kbader94/OpenActionCam/documentation/git_repo_qr.png

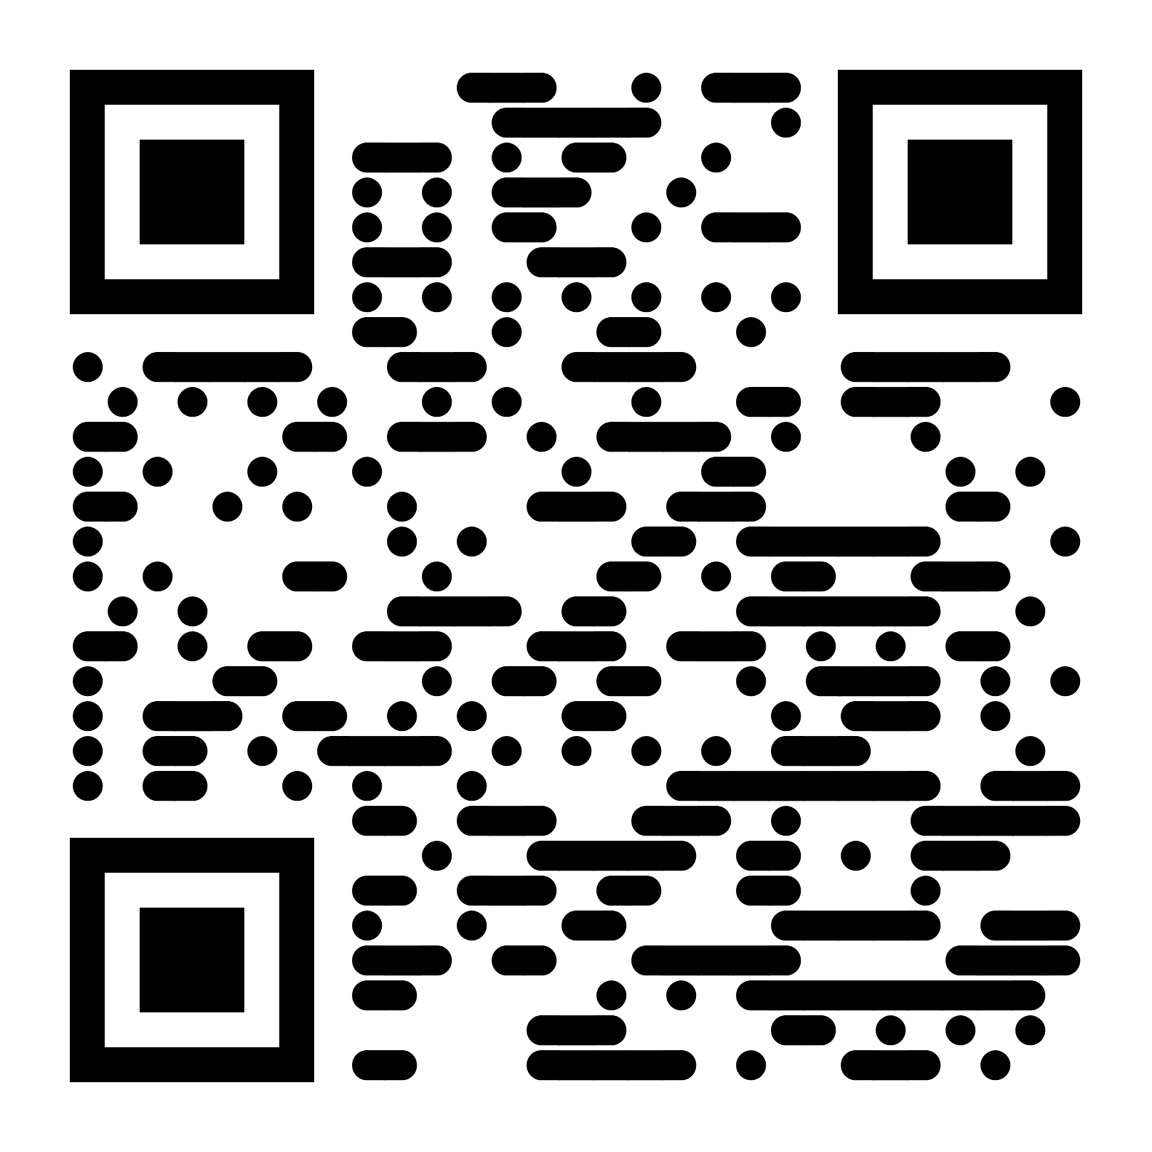
documentation/git_repo_qr.png
