kbader94/OpenActionCam/enclosure/camera_prototype_blank.FCStd

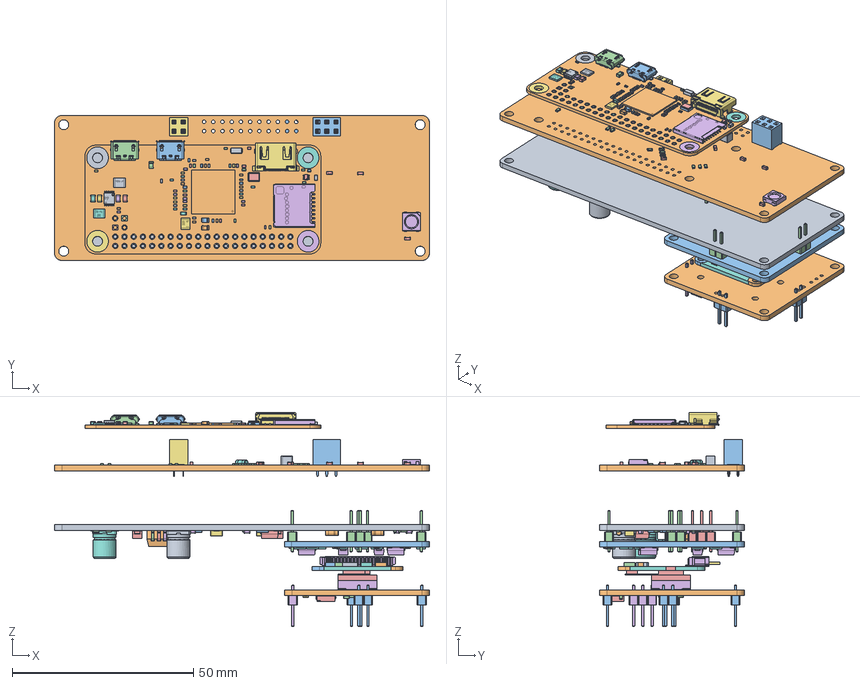
[picture p3: CAD file, 2025-04-18]
enclosure/camera_prototype_blank.FCStd
103.3 x 39.9 x 59.1 mm
Pcb_62cb
D13_D_MiniMELF_Standard_c2e3187f8d08 x 2
C33_R_1210_3225Metric_a984ca31e848 x 4
R29_R_0603_1608Metric_96e7c12605c0 x 8
D16_D_SMA_504832eae792 x 3
C21_C_0603_1608Metric_6fc8a7ce5464 x 8
F2_Fuse_1210_3225Metric_1070eb7e90c8 x 2
C_Elec_63x77
C_Elec_63x078
a648ce37-9c39-11ed-93f0-dde97e994e83_part
a648ce38-9c39-11ed-93f0-dde97e994e83_part
a648ce39-9c39-11ed-93f0-dde97e994e83_part
a648ce39-9c39-11ed-93f0-dde97e994e83_part001
a648ce39-9c39-11ed-93f0-dde97e994e83_part002
a648ce39-9c39-11ed-93f0-dde97e994e83_part003
a648ce39-9c39-11ed-93f0-dde97e994e83_part004
C8_CP_Elec_63x77_e0391a26d7e0
Pcb_15b3
J3_PinSocket_2x03_P254mm_Vertical_5ad157b1af12
R17_R_0603_1608Metric_1dbf1ae17e91 x 14
C16_C_0603_1608Metric_3bd57f6aa84f x 7
D10_LED_WS2812B_PLCC4_50x50mm_P32mm_2dee1f3dcbaa
J7_PinSocket_2x02_P254mm_Vertical_e2a5c2e6a80f
D11_D_MiniMELF_Standard_5cd850237788
C7_C_1210_3225Metric_9d8613c78238
Raspberry_pizero_PCB
Raspberry_pizero_PCB001
Raspberry_pizero_PCB002
Raspberry_pizero_PCB003
Raspberry_pizero_PCB004
Raspberry_pizero_PCB005
Raspberry_pizero_PCB006
Raspberry_pizero_PCB007
Raspberry_pizero_PCB008
Raspberry_pizero_PCB009
Raspberry_pizero_PCB010
Raspberry_pizero_PCB011
Raspberry_pizero_PCB012
Raspberry_pizero_PCB013
Raspberry_pizero_PCB014
Raspberry_pizero_PCB015
Raspberry_pizero_PCB016
Raspberry_pizero_PCB017
Raspberry_pizero_PCB018
Raspberry_pizero_PCB019
Raspberry_pizero_PCB020
Raspberry_pizero_PCB021
Raspberry_pizero_PCB022
Raspberry_pizero_PCB023
Raspberry_pizero_PCB024
Raspberry_pizero_PCB025
Raspberry_pizero_PCB026
Raspberry_pizero_PCB027
Raspberry_pizero_PCB028
Raspberry_pizero_PCB029
Raspberry_pizero_PCB030
Raspberry_pizero_PCB031
Raspberry_pizero_PCB032
Raspberry_pizero_PCB033
Raspberry_pizero_PCB034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
