kbader94/OpenActionCam/hardware/Assets/Crystal/ECS-160-20-33-TR/ECS-160-20-33-TR.step

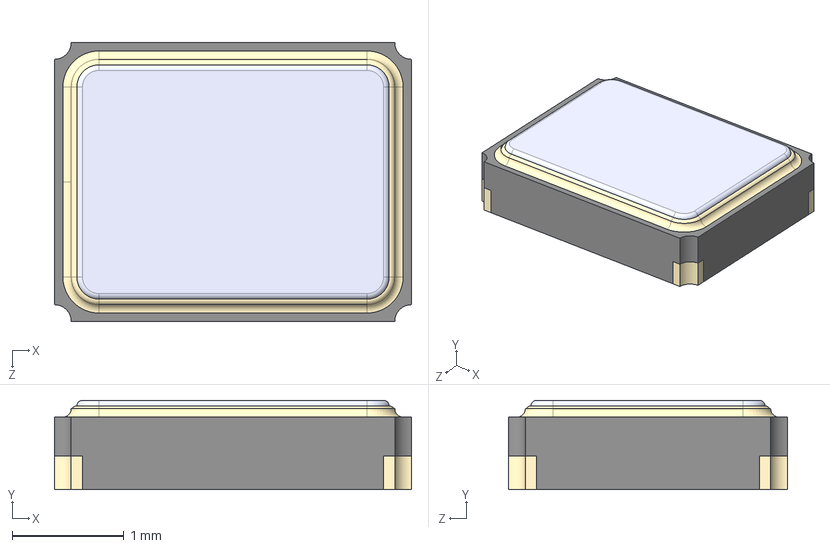
[picture p4: CAD file, 2025-05-10]
hardware/Assets/Crystal/ECS-160-20-33-TR/ECS-160-20-33-TR.step
3.20 x 0.8 x 2.50 mm
