kbader94/OpenActionCam/enclosure/Assets/Camera Moudule 3 v8.step

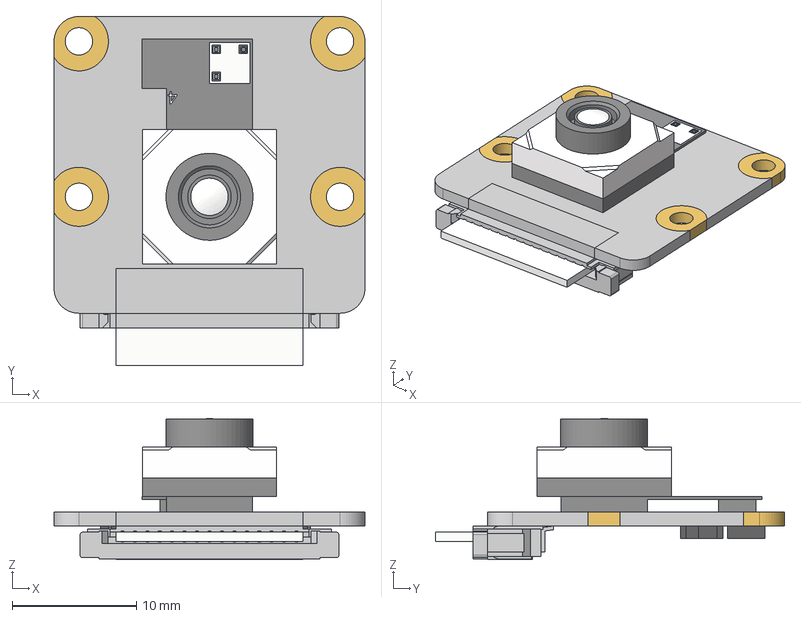
[picture p5: CAD file, 2025-04-18]
enclosure/Assets/Camera Moudule 3 v8.step
25.0 x 28.1 x 11.3 mm
Board
sfw15r3ste1lf
Sensor
Lens
Ring
Mount
Housing
