kbader94/OpenActionCam/enclosure/camera_prototype_1.FCStd

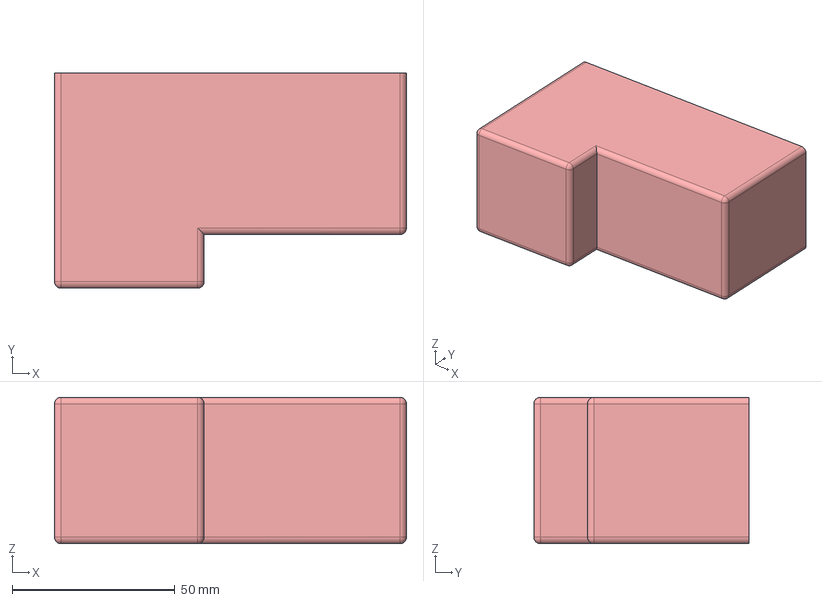
[picture p7: CAD file, 2025-04-18]
enclosure/camera_prototype_1.FCStd
108.2 x 66.2 x 45.0 mm
Pcb_580f
C12_C_0603_1608Metric_b34f059e5ce2
D9_LED_WS2812B_PLCC4_50x50mm_P32mm_70d8c241699f
R12_R_0603_1608Metric_c4ddf8fdb897
