kbader94/OpenActionCam/(list of files, cad)

Other CAD files:
enclosure/LED_Driver1.FCStd
enclosure/camera_prototype.FCStd
