kbader94/OpenActionCam/hardware/BMS/Fab/BMS-F_Fab.pdf

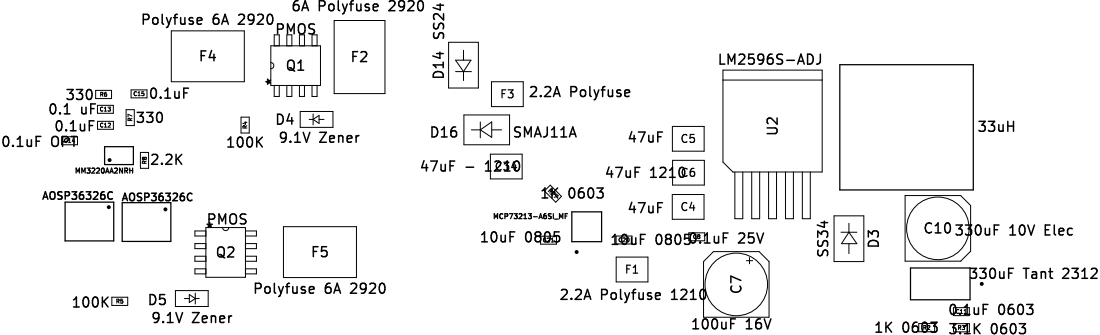
[picture p8: page 1]
