kbader94/OpenActionCam/hardware/Controller/Controller.kicad_pcb

## KiCad design hardware/Controller/Controller.kicad_pcb (2025-05-10)

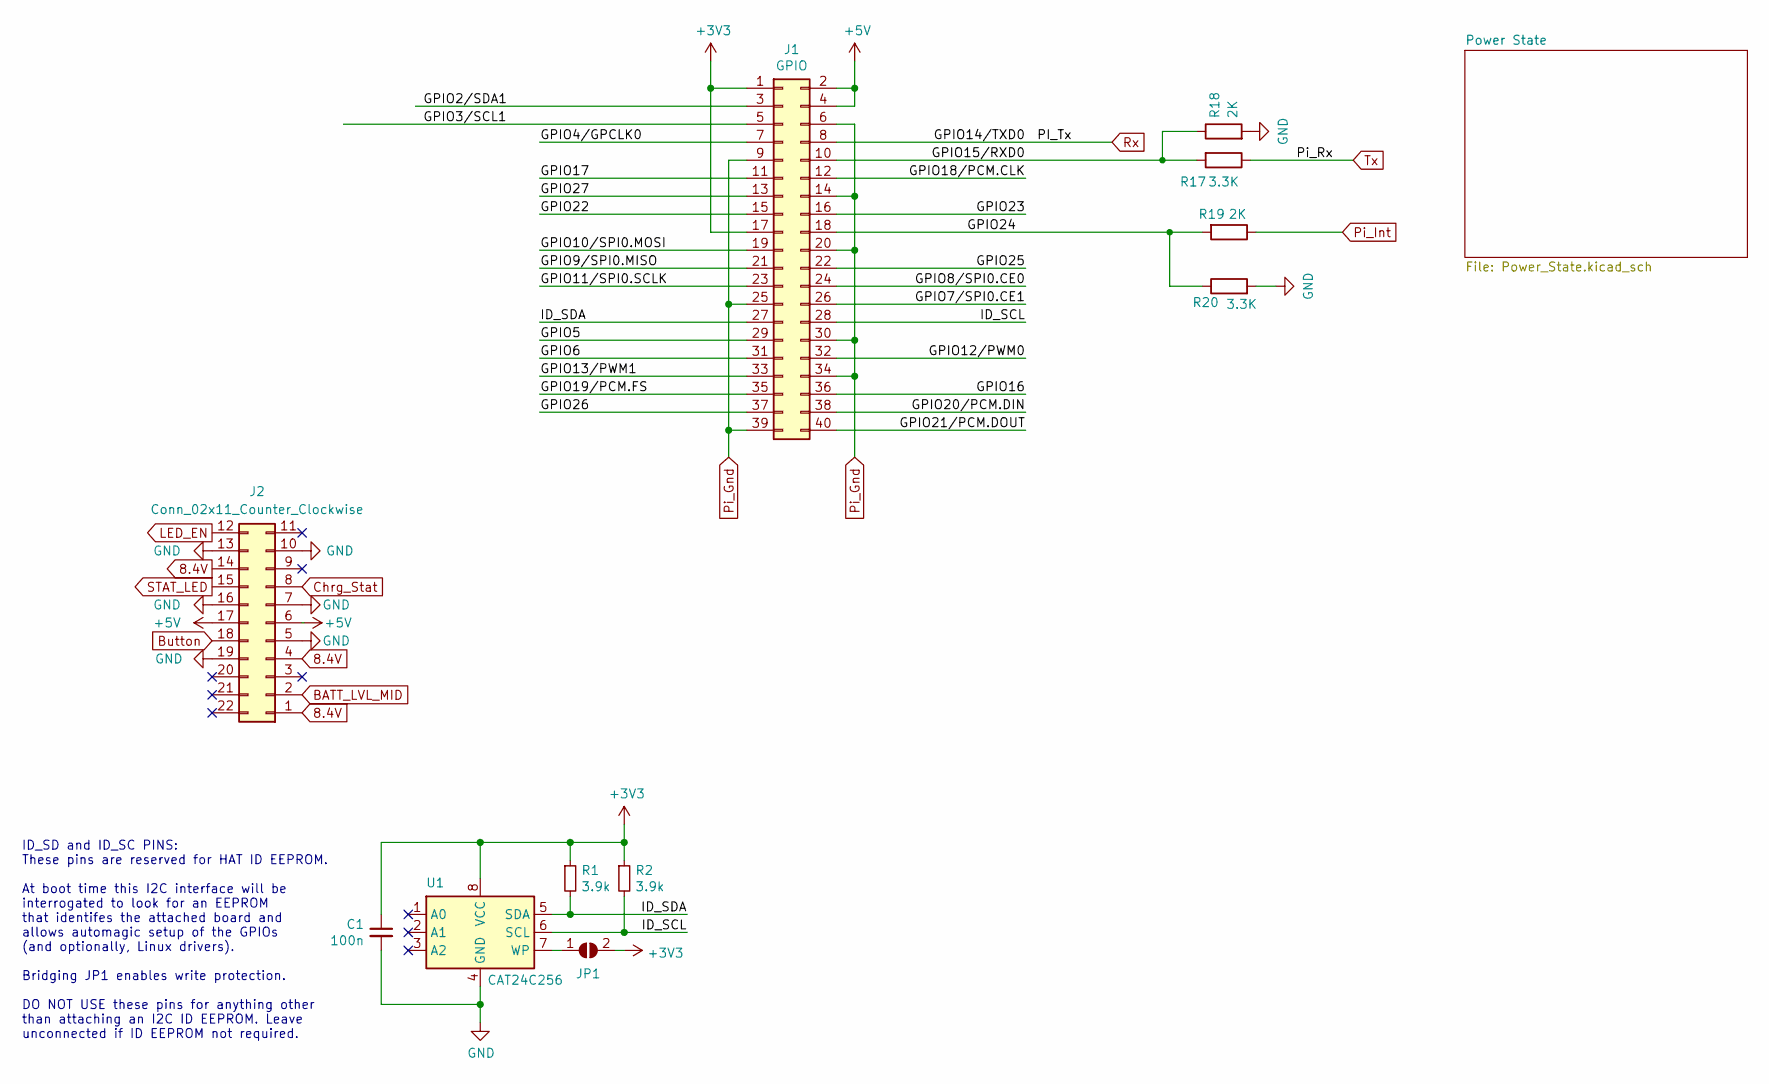
[picture p9: schematic Controller.kicad_sch, OpenActionCam]

Parts:
C1: 100n; C_0603_1608Metric_Pad1.08x0.95mm_HandSolder
J1: GPIO; Raspberry_Pi_Zero_Socketed_THT_FaceDown_MountingHoles
J2: Conn_02x11_Counter_Clockwise; Board_outline
JP1: ID_WP; SolderJumper-2_P1.3mm_Open_Pad1.0x1.5mm
R1, R2: 3.9k; R_0603_1608Metric_Pad0.98x0.95mm_HandSolder
R17, R20: 3.3K; R_0603_1608Metric_Pad0.98x0.95mm_HandSolder
R18, R19: 2K; R_0603_1608Metric_Pad0.98x0.95mm_HandSolder
U1: CAT24C256; SOIC127P600X175-8N

Connections:
8.4V: J2.1, J2.4, J2.14; also elsewhere on the board
+3V3: C1.1, J1.1, J1.17, JP1.2 (B), R1.1, R2.1, U1.8 (VCC)
+5V: J1.2, J1.4, J2.6, J2.17; also elsewhere on the board
/GPIO2/SDA1: J1.3
/GPIO3/SCL1: J1.5
/GPIO4/GPCLK0: J1.7
/GPIO5: J1.29
/GPIO6: J1.31
/GPIO7/SPI0.CE1: J1.26
/GPIO8/SPI0.CE0: J1.24
/GPIO9/SPI0.MISO: J1.21
/GPIO10/SPI0.MOSI: J1.19
/GPIO11/SPI0.SCLK: J1.23
/GPIO12/PWM0: J1.32
/GPIO13/PWM1: J1.33
/GPIO15/RXD0: J1.10, R17.2, R18.1
/GPIO16: J1.36
/GPIO17: J1.11
/GPIO18/PCM.CLK: J1.12
/GPIO19/PCM.FS: J1.35
/GPIO20/PCM.DIN: J1.38
/GPIO21/PCM.DOUT: J1.40
/GPIO22: J1.15
/GPIO23: J1.16
/GPIO24: J1.18, R19.1, R20.2
/GPIO25: J1.22
/GPIO26: J1.37
/GPIO27: J1.13
/ID_SCL: J1.28, R2.2, U1.6 (SCL)
/ID_SDA: J1.27, R1.2, U1.5 (SDA)
BATT_LVL_MID: J2.2; also elsewhere on the board
Button: J2.18; also elsewhere on the board
Chrg_Stat: J2.8; also elsewhere on the board
GND: C1.2, J2.5, J2.7, J2.10, J2.13, J2.16, J2.19, R18.2, R19.2, U1.4 (GND); also elsewhere on the board
LED_EN: J2.12; also elsewhere on the board
unnamed: JP1.1 (A), U1.7 (WP)
Pi_Gnd: J1.6, J1.9, J1.14, J1.20, J1.25, J1.30, J1.34, J1.39; also elsewhere on the board
Pi_Int: R20.1; also elsewhere on the board
Rx: J1.8; also elsewhere on the board
STAT_LED: J2.15; also elsewhere on the board
Tx: R17.1; also elsewhere on the board

Notes on the sheet:
ID_SD and ID_SC PINS: These pins are reserved for HAT ID EEPROM. At boot time this I2C interface will be interrogated to look for an EEPROM that identifes the attached board and allows automagic setup of the GPIOs (and optionally, Linux drivers). Bridging JP1 enables write protection. DO NOT USE th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

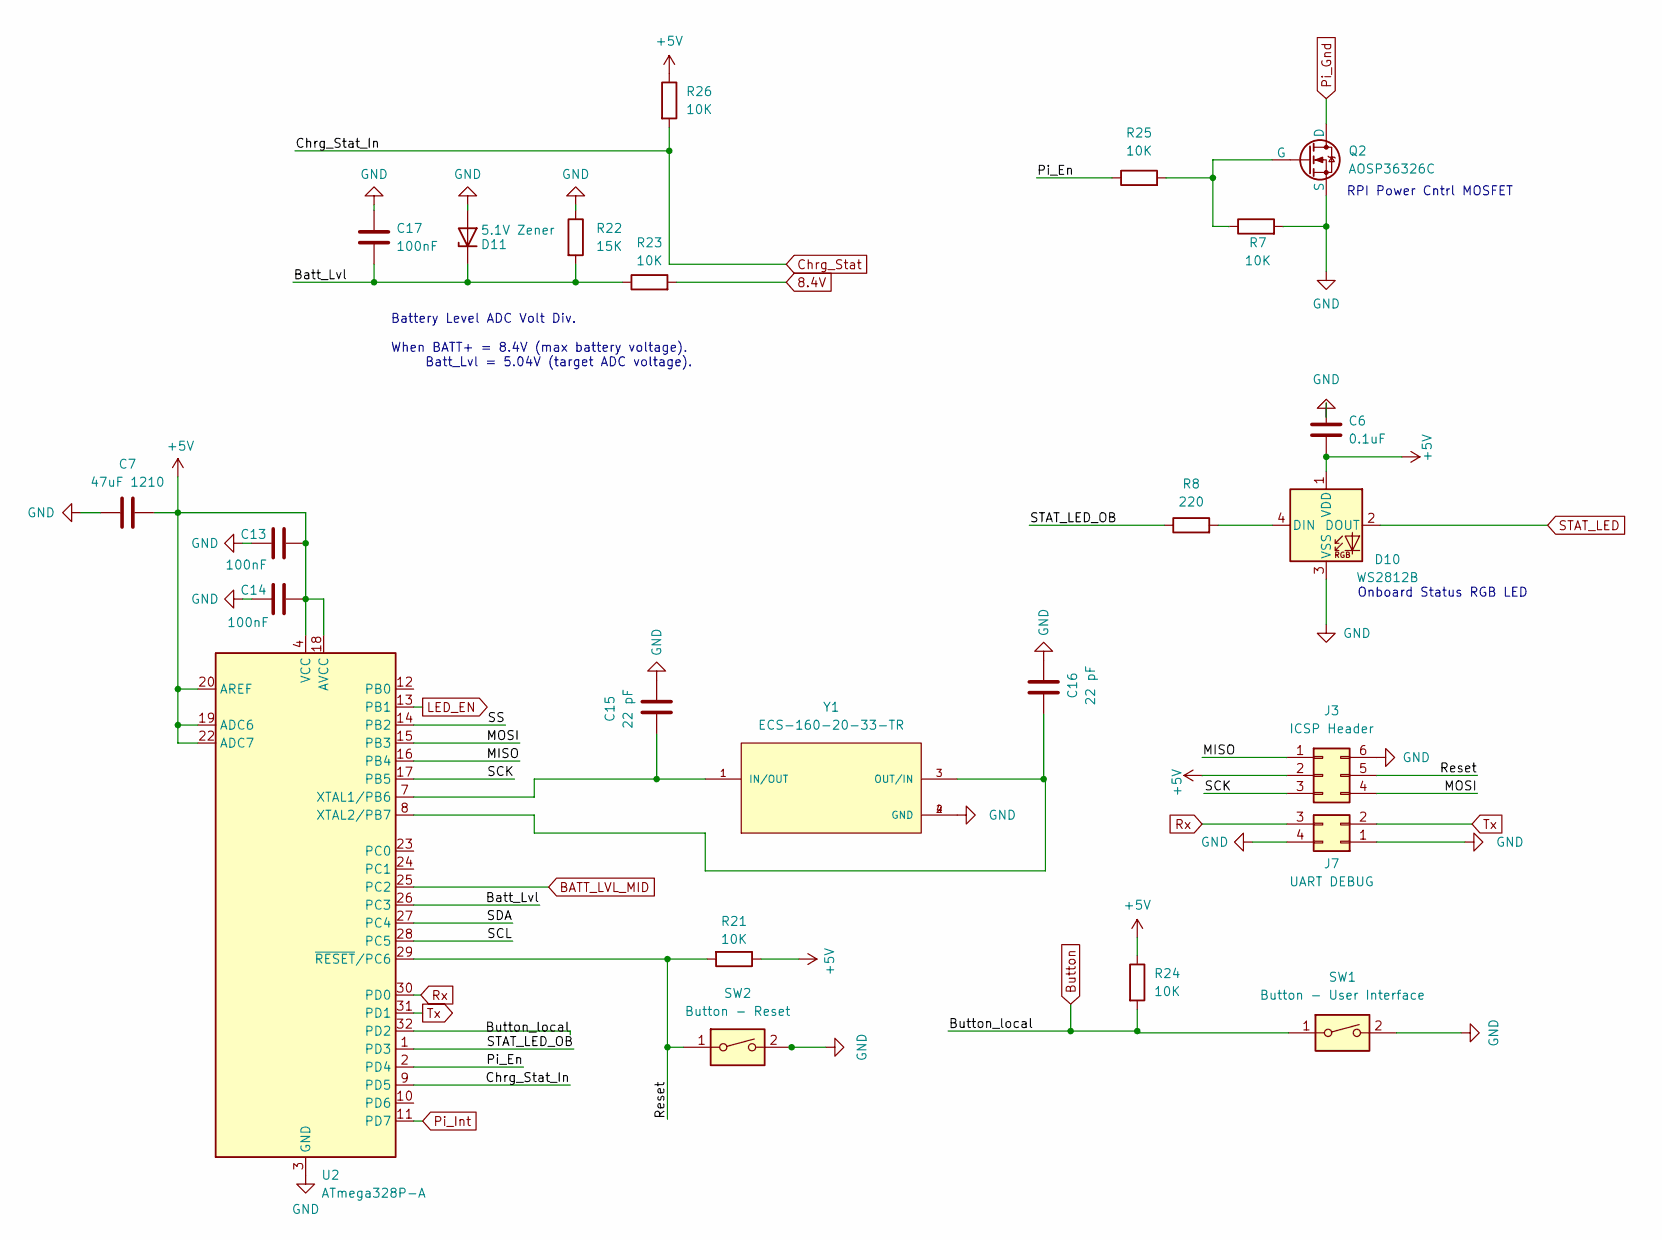
[picture p10: schematic Power_State.kicad_sch, OpenActionCam]

Parts:
C6: 0.1uF; C_0603_1608Metric_Pad1.08x0.95mm_HandSolder
C7: 47uF 1210; C_1210_3225Metric_Pad1.33x2.70mm_HandSolder
C13, C14, C17: 100nF; C_0603_1608Metric_Pad1.08x0.95mm_HandSolder
C15, C16: 22 pF; C_0603_1608Metric_Pad1.08x0.95mm_HandSolder
D10: WS2812B; LED_WS2812B_PLCC4_5.0x5.0mm_P3.2mm
D11: 5.1V Zener; D_SOD-323_HandSoldering
J3: ICSP Header; PinSocket_2x03_P2.54mm_Vertical
J7: UART DEBUG; PinSocket_2x02_P2.54mm_Vertical
Q2: AOSP36326C; SOIC127P490X600X175-8N
R7, R21, R23, R24: 10K; R_0603_1608Metric_Pad0.98x0.95mm_HandSolder
R8: 220; R_0603_1608Metric_Pad0.98x0.95mm_HandSolder
R22: 15K; R_0603_1608Metric_Pad0.98x0.95mm_HandSolder
R25, R26: 10K; R_0603_1608Metric
SW1: Button - User Interface; SW4_PTS815 SJM 250 SMTR LFS_CNK
SW2: Button - Reset; SW4_PTS815 SJM 250 SMTR LFS_CNK
U2: ATmega328P-A; TQFP-32_7x7mm_P0.8mm
Y1: ECS-160-20-33-TR; XTAL_ECS-160-20-33-TR

Connections:
8.4V: R23.2; also elsewhere on the board
+5V: C6.2, C7.2, C13.2, C14.2, D10.1 (VDD), J3.2, R21.1, R24.1, R26.1, U2.4 (VCC), U2.6 (VCC), U2.18 (AVCC), U2.19 (ADC6), U2.20 (AREF), U2.22 (ADC7); also elsewhere on the board
/Power State/Batt_Lvl: C17.2, D11.1 (K), R22.2, R23.1, U2.26 (PC3)
/Power State/MISO: J3.1, U2.16 (PB4)
/Power State/MOSI: J3.4, U2.15 (PB3)
/Power State/Pi_En: R25.1, U2.2 (PD4)
/Power State/Reset: J3.5, R21.2, SW2.1, U2.29 (~RESET/PC6)
/Power State/SCK: J3.3, U2.17 (PB5)
/Power State/SCL: U2.28 (PC5)
/Power State/SDA: U2.27 (PC4)
/Power State/SS: U2.14 (PB2)
/Power State/STAT_LED_OB: R8.1, U2.1 (PD3)
BATT_LVL_MID: U2.25 (PC2); also elsewhere on the board
Button: R24.2, SW1.1, U2.32 (PD2); also elsewhere on the board
Chrg_Stat: R26.2, U2.9 (PD5); also elsewhere on the board
GND: C6.1, C7.1, C13.1, C14.1, C15.2, C16.2, C17.1, D10.3 (VSS), D11.2 (A), J3.6, J7.1, J7.4, Q2.3 (S), R7.2, R22.1, SW1.2, SW2.2, U2.3 (GND), U2.5 (GND), U2.21 (GND), Y1.2 (GND), Y1.4 (GND); also elsewhere on the board
LED_EN: U2.13 (PB1); also elsewhere on the board
unnamed: D10.4 (DIN), R8.2
unnamed: Q2.2 (G), R7.1, R25.2
unnamed: C15.1, U2.7 (XTAL1/PB6), Y1.1 (IN/OUT)
unnamed: C16.1, U2.8 (XTAL2/PB7), Y1.3 (OUT/IN)
Pi_Gnd: Q2.1 (D); also elsewhere on the board
Pi_Int: U2.11 (PD7); also elsewhere on the board
Rx: J7.3, U2.30 (PD0); also elsewhere on the board
STAT_LED: D10.2 (DOUT); also elsewhere on the board
Tx: J7.2, U2.31 (PD1); also elsewhere on the board

Notes on the sheet:
Onboard Status RGB LED
RPI Power Cntrl MOSFET
Battery Level ADC Volt Div. When BATT+ = 8.4V (max battery voltage). Batt_Lvl = 5.04V (target ADC voltage).

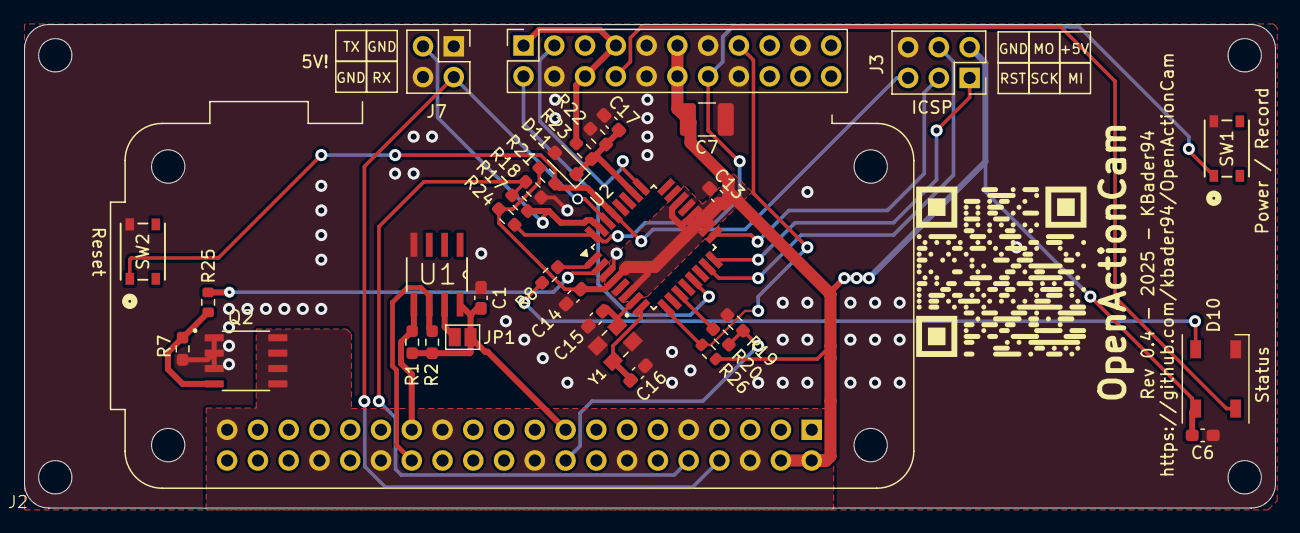
[picture p11: board Controller.kicad_pcb from above]

Board: 2 copper layers, 103.3 x 39.9 mm, 35 parts (1 on the bottom side), 29 nets.
