kbader94/OpenActionCam/hardware/BMS/BMS.kicad_pcb

## KiCad design hardware/BMS/BMS.kicad_pcb (2025-05-10)

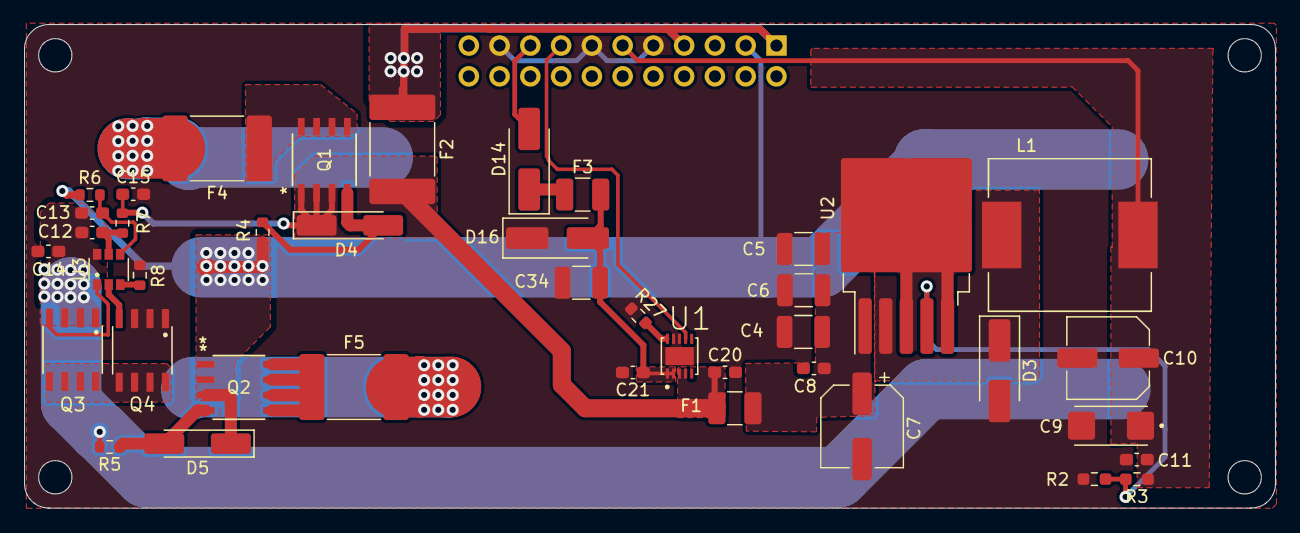
[picture p12: board BMS.kicad_pcb from above]

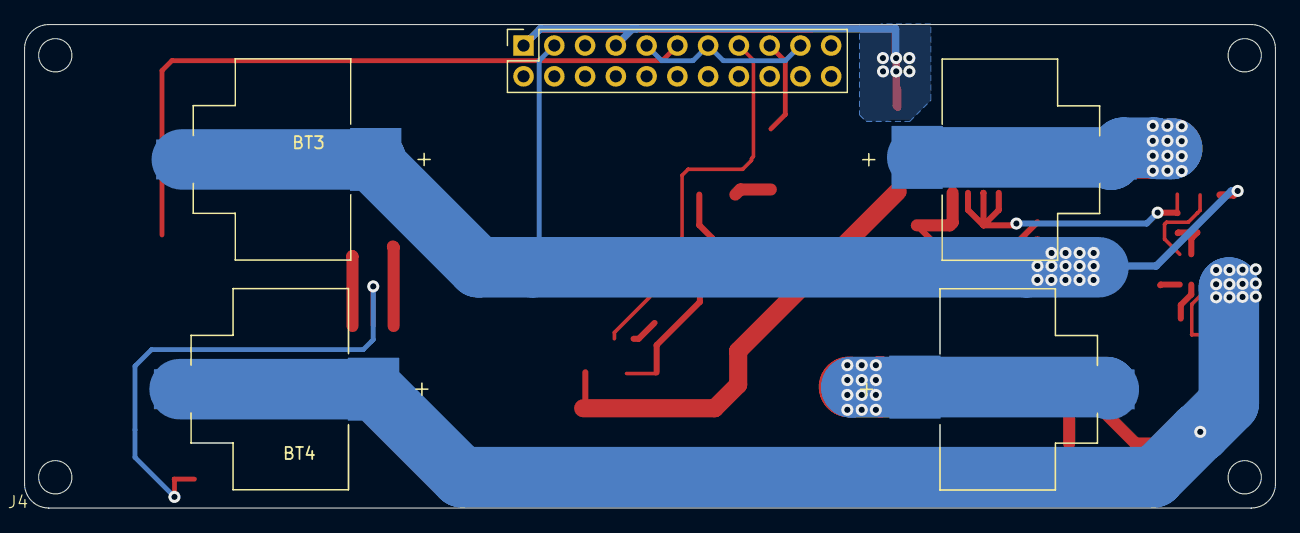
[picture p13: board BMS.kicad_pcb from below]

Board: 2 copper layers, 103.3 x 39.9 mm, 44 parts (3 on the bottom side), 26 nets.

Parts:
BT3, BT4: Battery_Cell; BAT_254
C4, C5, C6, C34: 47uF; R_1210_3225Metric_Pad1.30x2.65mm_HandSolder
C7: 100uF 16V; CP_Elec_6.3x7.7
C8, C11, C12, C14, C15: 0.1uF; C_0603_1608Metric_Pad1.08x0.95mm_HandSolder
C9: 330uF Tantalum; CAPPM6032X280N
C10: 330uF 10V; C_Elec_6.3x7.7
C13: 0.1 uF; C_0603_1608Metric_Pad1.08x0.95mm_HandSolder
C20, C21: 10uF; C_0603_1608Metric_Pad1.08x0.95mm_HandSolder
D3: SS34; D_SMA_Handsoldering
D4, D5: 9.1V Zener; D_MiniMELF_Handsoldering
D14: SS24; D_SMA_Handsoldering
D16: SMAJ11A; D_SMA_Handsoldering
F1, F3: 2.2A Polyfuse; Fuse_1210_3225Metric_Pad1.42x2.65mm_HandSolder
F2: 6A Polyfuse; Fuse_2920_7451Metric_Pad2.10x5.45mm_HandSolder
F4, F5: Polyfuse 6A; Fuse_2920_7451Metric_Pad2.10x5.45mm_HandSolder
J4: Conn_01x11; Board_outline
L1: 33uH; IND_125CDMCCDS-330MC
Q1, Q2: SI4435FDY; SO-8_VIS
Q3, Q4: AOSP36326C; SOIC127P490X600X175-8N
R2: 1K; R_0603_1608Metric_Pad0.98x0.95mm_HandSolder
R3: 3.1K; R_0603_1608Metric_Pad0.98x0.95mm_HandSolder
R4, R5: 100K; R_0603_1608Metric
R6, R7: 330; R_0603_1608Metric
R8: 2.2K; R_0603_1608Metric
R27: 1K; R_0603_1608Metric
U1: MCP73213-A6SI_MF; SON50P300X300X100-11N
U2: LM2596S-ADJ; TO-263-5_TabPin3
U3: MM3220AA2NRH; IC_MM3220AA2NRH

Connections:
8.4V: C15.1, C20.1, D4.1 (K), F1.1, F2.2, Q1.3 (S), R7.2, U1.3 (VBAT), U1.4 (VBAT)
+5V: C9.1, C10.1, C11.1, J4.6, L1.2, R3.1
+12V: C21.1, C34.2, D16.2 (A2), F3.2, U1.1 (VDD), U1.2 (VDD)
/Power BMS/8.4V Out: F2.1, J4.1, J4.4
/Power BMS/Battery Pack & Protection/8.4unsafe: F4.1, Q1.1 (D)
/Power BMS/Battery Pack & Protection/d2d: Q3.1 (D), Q4.1 (D)
/Power BMS/Power Supply/V_Out_Dirty: D3.1 (K), L1.1, U2.2 (OUT)
/Power BMS/Power Supply/Vin_clean: C4.1, C5.1, C6.1, C7.1, C8.1, F1.2, U2.1 (VIN)
BATT_LVL-: BT4.2 (-), C12.1, C13.2, C14.2, Q3.3 (S), R5.2, U3.6 (VSS)
BATT_LVL_MID: BT3.2 (-), D5.1 (K), J4.2, Q2.3 (S), R4.2, R6.1
Chrg_Stat: J4.8, U1.7 (STAT)
GND: C4.2, C5.2, C6.2, C7.2, C8.2, C9.2, C10.2, C11.2, C14.1, C15.2, C20.2, C21.2, C34.1, D3.2 (A), D16.1 (A1), J4.5, J4.7, J4.10, Q4.3 (S), R2.1, R8.2, R27.1, U1.8 (VSS), U1.9 (VSS), U1.11 (EP), U2.3 (GND), U2.5 (~ON/OFF)
unnamed: BT3.1 (+), F4.2
unnamed: BT4.1 (+), F5.2
unnamed: D4.2 (A), Q1.2 (G), R4.1
unnamed: D5.2 (A), Q2.2 (G), R5.1
unnamed: D14.2 (A), J4.9
unnamed: D14.1 (K), F3.1
unnamed: F5.1, Q2.1 (D)
unnamed: Q3.2 (G), U3.1 (DOUT)
unnamed: Q4.2 (G), U3.2 (COUT)
unnamed: R27.2, U1.10 (PROG)
unnamed: R2.2, R3.2, U2.4 (FB)
unnamed: R8.1, U3.3 (V-)
unnamed: C13.1, R6.2, U3.4 (VBL)
unnamed: C12.2, R7.1, U3.5 (VDD)
