kbader94/OpenActionCam/hardware/LED_Driver/LED_Driver.kicad_pcb

## KiCad design hardware/LED_Driver/LED_Driver.kicad_pcb (2025-04-18)

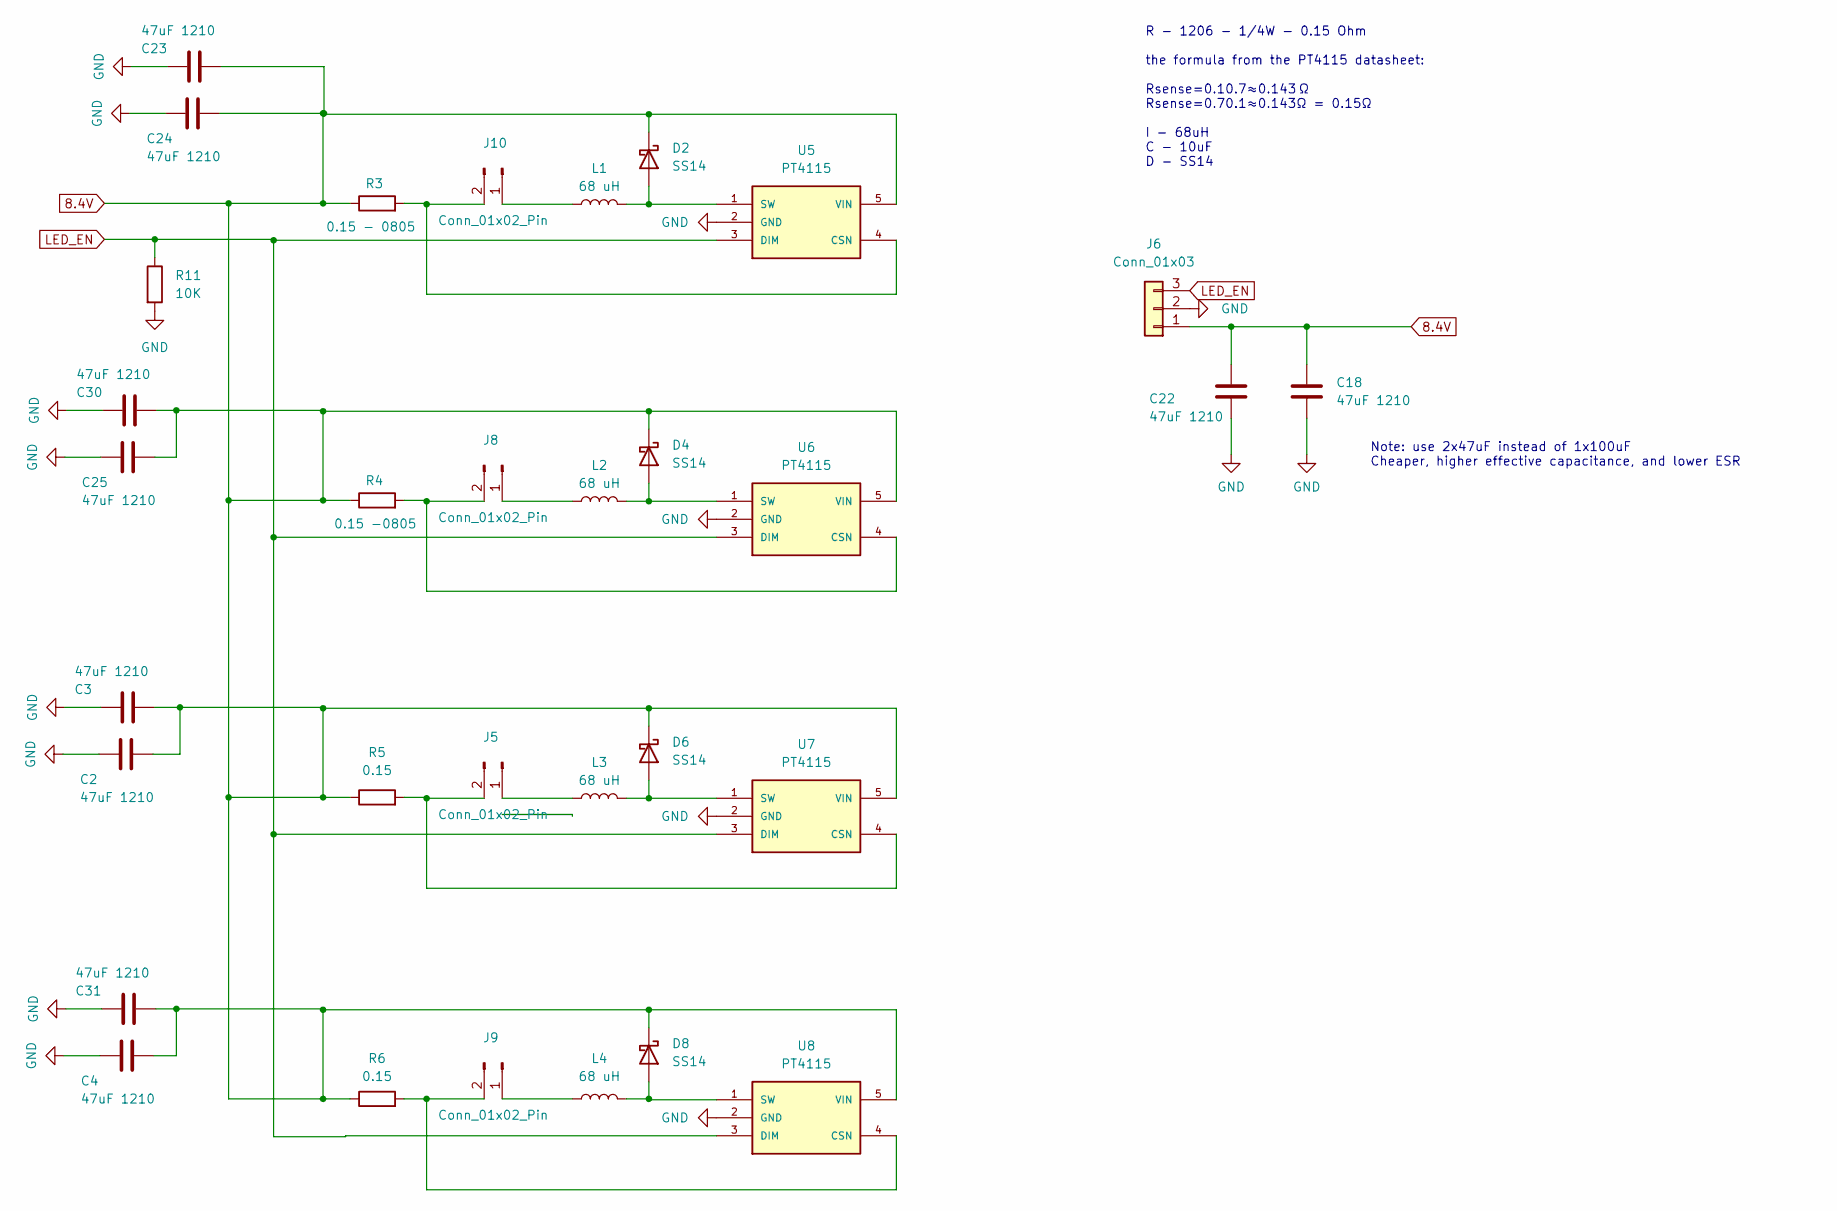
[picture p14: schematic LED_Array.kicad_sch, OpenActionCam]

Parts:
C2, C3, C4, C18, C22, C23, C24, C25, C30, C31: 47uF 1210; R_1210_3225Metric_Pad1.30x2.65mm_HandSolder
D2, D4, D6, D8: SS14; D_SMA_Handsoldering
J5, J8, J9, J10: Conn_01x02_Pin; PinHeader_1x02_P2.54mm_Vertical
J6: Conn_01x03; PinHeader_1x03_P2.54mm_Vertical
L1, L2, L3, L4: 68 uH; DR74
R3: 0.15 - 0805; R_0805_2012Metric_Pad1.20x1.40mm_HandSolder
R4: 0.15 -0805; R_0805_2012Metric_Pad1.20x1.40mm_HandSolder
R5, R6: 0.15; R_0805_2012Metric_Pad1.20x1.40mm_HandSolder
R11: 10K; R_0603_1608Metric_Pad0.98x0.95mm_HandSolder
U5, U6, U7, U8: PT4115; SOT-89-5

Connections:
8.4V: C2.1, C3.1, C4.1, C18.1, C22.1, C23.1, C24.1, C25.1, C30.1, C31.1, D2.1 (K), D4.1 (K), D6.1 (K), D8.1 (K), J6.1, R3.1, R4.1, R5.1, R6.1, U5.5 (VIN), U6.5 (VIN), U7.5 (VIN), U8.5 (VIN)
GND: C2.2, C3.2, C4.2, C18.2, C22.2, C23.2, C24.2, C25.2, C30.2, C31.2, J6.2, R11.2, U5.2 (GND), U6.2 (GND), U7.2 (GND), U8.2 (GND)
LED_EN: J6.3, R11.1, U5.3 (DIM), U6.3 (DIM), U7.3 (DIM), U8.3 (DIM)
unnamed: D2.2 (A), L1.2, U5.1 (SW)
unnamed: D4.2 (A), L2.2, U6.1 (SW)
unnamed: D6.2 (A), L3.2, U7.1 (SW)
unnamed: D8.2 (A), L4.2, U8.1 (SW)
unnamed: J5.1, L3.1
unnamed: J5.2, R5.2, U7.4 (CSN)
unnamed: J8.1, L2.1
unnamed: J8.2, R4.2, U6.4 (CSN)
unnamed: J9.1, L4.1
unnamed: J9.2, R6.2, U8.4 (CSN)
unnamed: J10.1, L1.1
unnamed: J10.2, R3.2, U5.4 (CSN)

Notes on the sheet:
R - 1206 - 1/4W - 0.15 Ohm the formula from the PT4115 datasheet: Rsense=0.10.7≈0.143 Ω Rsense =0.70.1 ≈0.143Ω = 0.15Ω I - 68uH C - 10uF D - SS14
Note: use 2x47uF instead of 1x100uF Cheaper, higher effective capacitance, and lower ESR

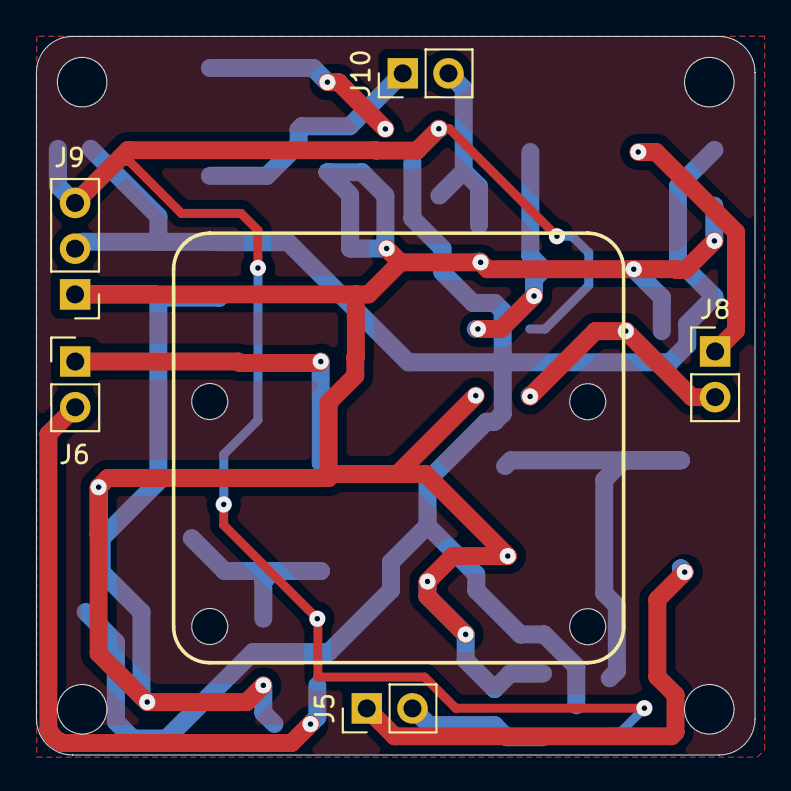
[picture p15: board LED_Driver.kicad_pcb from above]

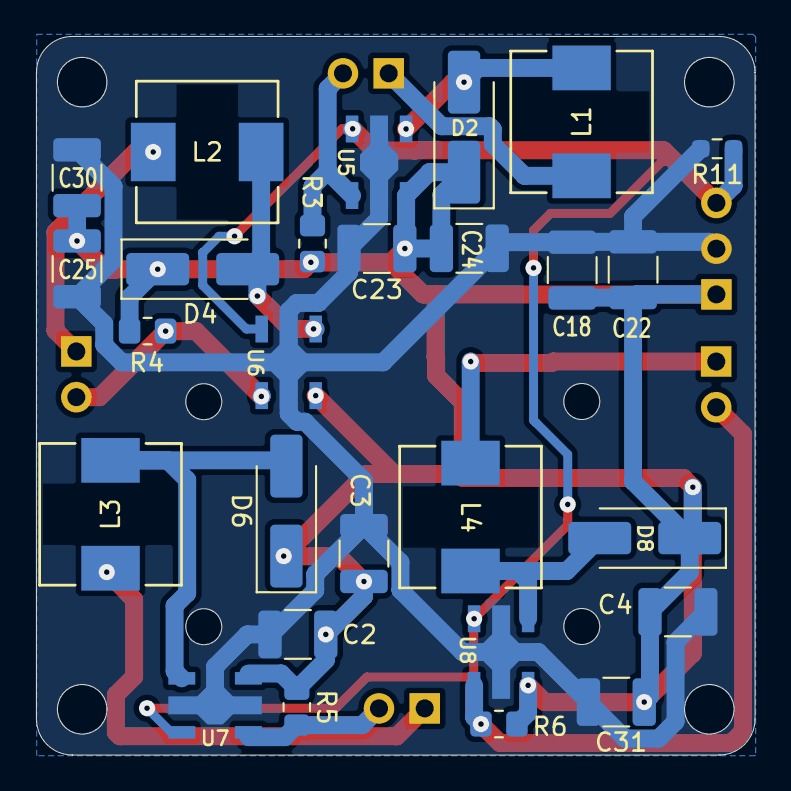
[picture p16: board LED_Driver.kicad_pcb from below]

Board: 2 copper layers, 39.9 x 39.9 mm, 32 parts (27 on the bottom side), 15 nets.
