kbader94/OpenActionCam/hardware/LEDs/LEDs.kicad_pcb

## KiCad design hardware/LEDs/LEDs.kicad_pcb (2025-04-12)

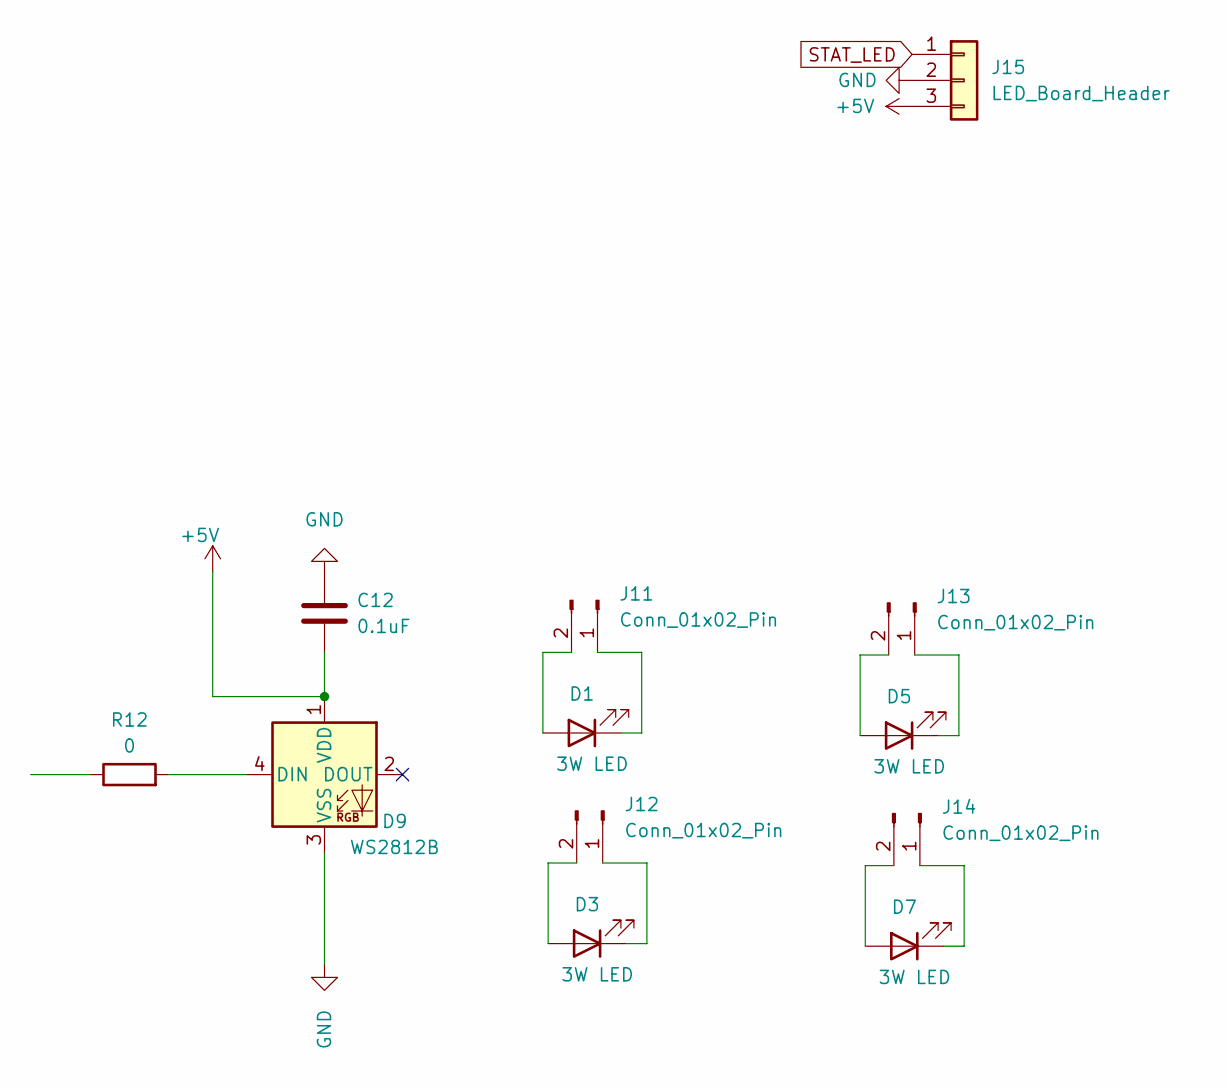
[picture p17: schematic LED_Array.kicad_sch, OpenActionCam]

Parts:
C12: 0.1uF; C_0603_1608Metric_Pad1.08x0.95mm_HandSolder
D1, D3, D5, D7: 3W LED; BEAD-3W-W-120-04
D9: WS2812B; LED_WS2812B_PLCC4_5.0x5.0mm_P3.2mm
J11, J12, J13, J14: Conn_01x02_Pin; PinHeader_1x02_P2.54mm_Vertical
J15: LED_Board_Header; PinHeader_1x03_P2.54mm_Vertical
R12: 0; R_0603_1608Metric_Pad0.98x0.95mm_HandSolder

Connections:
+5V: C12.2, D9.1 (VDD), J15.3
GND: C12.1, D9.3 (VSS), J15.2
unnamed: D1.2 (A), J11.2
unnamed: D1.1 (K), J11.1
unnamed: D3.2 (A), J12.2
unnamed: D3.1 (K), J12.1
unnamed: D5.2 (A), J13.2
unnamed: D5.1 (K), J13.1
unnamed: D7.2 (A), J14.2
unnamed: D7.1 (K), J14.1
unnamed: D9.4 (DIN), R12.2
STAT_LED: J15.1

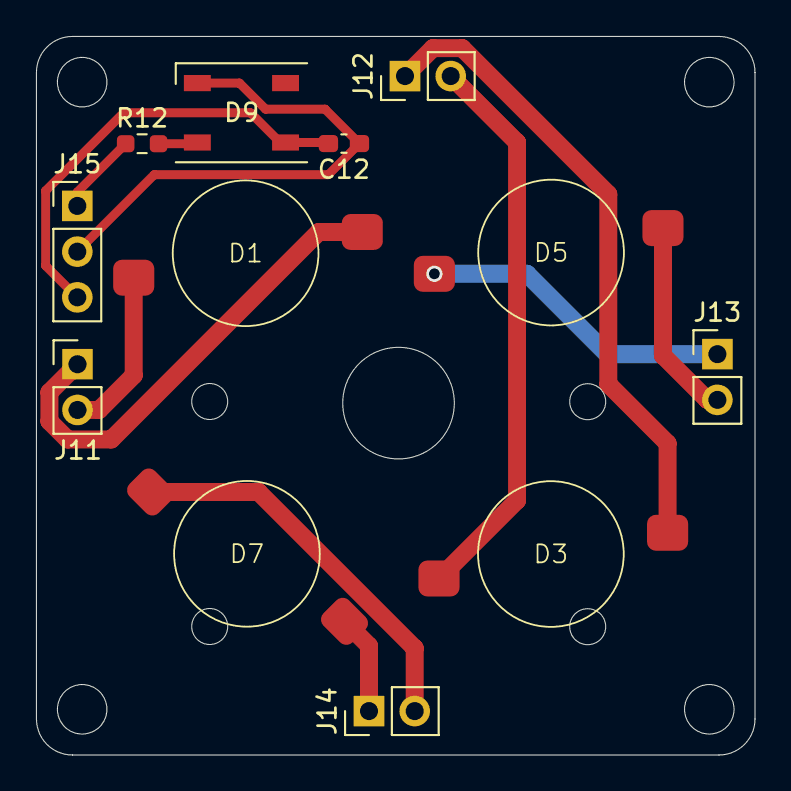
[picture p18: board LEDs.kicad_pcb from above]

Board: 2 copper layers, 39.9 x 39.9 mm, 12 parts (0 on the bottom side), 11 nets.
