kbader94/OpenActionCam/(commit log)

2025-02-27 Initial commit
    Initial implementation of basic power state management and IO prototype
    V0.1
    Changes to be committed:
    new file: blink_led_animation.cpp
    new file: blink_led_animation.h
    new file: error.cpp
    new file: error.h
    new file: iJet.ino
    new file: led.cpp
    new file: led.h
    new file: led_animation.h
    new file: rainbow_led_animation.cpp
    new file: rainbow_led_animation.h
    [blink_led_animation.cpp, blink_led_animation.h, error.cpp, error.h, led.cpp, led.h, led_animation.h, rainbow_led_animation.cpp]
2025-03-01 Modifies throwError and blink_led_animation to be singleton's with updatable error code to allow resetting device with errors from the UI button. Adds initial file to seperate logic for Power Mangeme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
    On branch master
    modified: blink_led_animation.cpp
    modified: blink_led_animation.h
    modified: error.cpp
    modified: error.h
    modified: iJet.ino
    modified: led.cpp
    new file: power_management.cpp
    new file: power_management.h
    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
    [blink_led_animation.cpp, blink_led_animation.h, error.cpp, error.h, led.cpp]
2025-03-02 Modifies error handling to use Macros, supports warnings and debug messaging. Also integrates the logic for device state changes during errors into the error handler itself for better SoC.
    modified: power_management.cpp
    modified: power_management.h
    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
    [error.cpp, error.h]
2025-03-17 Refactor entire project - move arduino code to /arduino Import rpi code in /linux Create comms.c - portable serial comms between atmega and linux Add symlinks to comms.c and comms.h in /arduino and /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
2025-03-18 Major Project Refactor Finished implementing comms.c - portable comms code Create serial_wrapper to facilitage portable comms code Rename arduino directory to firmware Add makeFile for linux program 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
2025-03-20 implement error handling on linux system
    [comms.c, error.h, main.c, record.c, record.h]
2025-03-20 Send errors to firmware cleanup comms.h
    [comms.h, error.h]
2025-03-21 Implements error forwarding on firmware. Errors on the linux system can now be forwarded to the firmware to display to the user. Refactor power_management to use comms.c for commands Initialize messa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
    [comms.c, comms.h, error.h, firmware.ino]
2025-03-21 various syntactic and semantic fixes
    [comms.c, comms.h, error.h, firmware.ino, main.c, serial_wrapper.cpp, serial_wrapper.h]
2025-03-23 firmware - formatting & cleanup linux/error.h comms_send_error() linux/main.c listen for Error Messages linux/record.c - Monitor recording output for errors comms.c/h - serialize & deserialize messge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
    [comms.c, comms.h, error.h, firmware.ino, main.c, record.c]
2025-03-24 Add debug support for linux_camera in scripts and makefile firmware cleanup comms cleanup and error handling
    [comms.c, comms.h, firmware.ino]
2025-03-25 Error Handling refactor error.h/cpp - * Make code portable and shared between linux and firmware. * Change error definitions to include device origin. Do not send errors back to origin. * Properly in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
    [blink_led_animation.cpp, error.cpp, error.h, firmware.ino, led.cpp, main.c, record.c]
2025-03-25 Error Handling Cleanup * Slow down LED blink in firmware * Fix/add throw_error() in linux/error.cpp * Reduce error code ints for better readability via LED
    [blink_led_animation.h, error.cpp, error.h, led.cpp]
2025-03-26 import hardware
    [LED_Array.kicad_sch, Power Boost.kicad_sch, Power Charge.kicad_sch, Power Supply.kicad_sch, Power_State.kicad_sch, Power_Supply.kicad_sch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]
2025-03-27 Firmware - Support low power sleep * Add support for sleep via power-down and wake on interrupt INT0 * Fixed broken script paths after importing hardware and moving software
    [firmware.ino]
2025-03-29 Disable peripherals in low power state * Add logic to disable and re-enable peripherals when entering and exiting a low power state
2025-03-29 Transmit status
    firmware.ino:
    * implements read_battery_voltage() - read battery level
    * implements transmit_status_message - Periodically transmit a status message
    * code cleanup: rename press_duration to button_press_duration for clarity
    comms.h:
    * refactor struct StatusBody to use float for battery_level and uint8 for error_code
    [comms.h, firmware.ino]
2025-03-30 Process status messages
    linux software
    * Refactor main loop to process status messsages
    * code cleanup in main.c: use DEBUG_MESSAGE macro instead of printf
    firmware:
    * firmware.ino - sleep_until_button_press is broken, disable for now.
    [firmware.ino, main.c]
2025-03-31 Firmware errors for low and high battery voltages firmware.ino: * change read_battery_voltage() to average multiple samples * add check for battery voltage level errors in main loop
    error.h:
    * Add low and high battery voltage error definition macros, ERR_LOW_BATTERY and ERR_BATTERY_OV
    [error.h, firmware.ino]
2025-04-06 Hardware V0.2 - Schematics update
    Combines Cell holder, BMS, and voltage regulator into single board
    complete w. extensive electrical and thermal protections including:
    * MM3220 BMS w Overvoltage, Overcurrent, undervoltage charging/discharge protect
    * Fuses on cells, 12v in, 5v and 8.4v out.
    * Reverse polarity protection on 12v and cells.
    Adds debug UART header
    Single IO header on every board
    Minor component size corrections
    Add current limiting resistor to RPI power NMOS gate.
    Add optional support for MLCC/tantalum caps for Voltage Regulator instead of electrolytic
    [254.STEP, 254.step, AOSP36326C.step, DR74.step, LED_Array.kicad_sch, Power Boost.kicad_sch, Power Supply.kicad_sch, Power_State.kicad_sch]
2025-04-11 Hardware revision 0.2 routing
    [ATMEGA328-AU.step, CAT24C256WI-GT3.step, ECS-160-20-5PX-TR.step, LED_Array.kicad_sch, MCP73213-A6SI_MF.step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]
2025-04-12 Seperate PCBs into individual KiCAD projects
    [254.STEP, 254.step, AOSP36326C.step, ATMEGA328-AU.step, BMS.kicad_pcb, BMS.kicad_sch, CAT24C256WI-GT3.step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]
2025-04-18 Hardware cleanup & enclosure prototype
    * Seperates the kicad project into seperate projects per PCB
    * initial FreeCAD Assets and prototypes added
    [254.STEP, 254.step, AOSP36326C.step, ATMEGA328-AU.step, BMS.kicad_pcb, BMS.kicad_sch, CAT24C256WI-GT3.step, Camera Moudule 3 v8.step]
2025-05-10 Hardware - Controller - Rev 0.3
    * Consolidate various asset dirs into single symlinked directory.
    * Fixes major flaw with previous atmega328 layout - wrong schematic symbol caused incorrect routing
    * Use smaller crystal closer to mcu
    * Add QR to silkscreen
    [254.STEP, 254.step, AOSP36326C.step, ATMEGA328-AU.step, BMS.kicad_pcb, BMS.kicad_sch, CAT24C256WI-GT3.step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]
2025-05-11 Update comms protocol
    * Move checksum into header;
    * Checksum entire message incl header;
    Initial Watchdog driver
    * Export oac_send_message from oac_dev.c;
    * Add watchdog ops to oac_watchdog.c;
2025-05-13 OAC driver * Fix compile error in oac_watchdog.c * Fix: return actual error val(-EINVAL) in oac_send_message
2025-05-15 Watchdog Driver & OACD watchdog service
    OAC Drivers
    * Implement watchdog driver, inc start,stop, and ping wdd->ops
    * Rename oac directory and install script to drivers
    OACD
    * Implement oacd - systemd service for oacd watchdog services. Pings systemd AND watchdog device(/dev/watchdog1)
    * Implement oacd makefile and remote install script
2025-05-17 Support for oac watchdog driver from firmware side
    oac_dev.c - Core serdev driver
    * Fix - use proper serial baud rate
    oac_comms.c - serdev comms
    * Fix - validate checksum
    * Fix - move checksum into header during serialization
    comms.c - firmware comms
    * Move checksum check exclusively to comms_deserialize_messge to reduce redundancy.
    * Remove individual functions for sending message types. Messages will be sent exclusively with send_message
    * Implement comms_validate_checksum for validating messges
    [comms.c, comms.h, firmware.ino]
2025-05-21 oac_comms.c & comms.c * Refactor - change get_param / set_param to command / response
    oac_dev.c
    * Implement oac_dev_register_callback
    * Implement oac_dev_unregister_callback
    * Implement oac_dev_message_registered_callbacks
    oac_button.c
    * Initial implementation of button input dev driver
2025-05-25 REFACTOR power_management => system_state * Refactor power_management * Implement function for processStateTransition to seperate logic for state transition
2025-05-25 oac_battery.c
    * Fix(dur) - change Message struct StatusBody to use uint32
    * Implement oac_battery.c - battery driver
    [comms.c, comms.h, firmware.ino, main.c]
2025-05-26 fix - LED on when dev off
    [firmware.ino]
2025-05-29 ALL THE FIXES
    This commit contains all the fixes for initial implementations of oac_watchdog, oac_button, and oac_battery. At this point the
    firmware.ino
    * Fix battery voltage always low
    oac_battery.c
    * Make *bat global singleton
    * use psy_cfg in oac_batty_probe
    * use global *bat in oac_message_callback and oac_battery_probe
    oac_comms.c
    * Fix use proper length in checksum validation
    * Fix syntax in oac_dev_message_registered_callbacks()
    * Export oac_dev_register_callbacks & oac_dev_message_unregister_callbacks
    * Fix expected_length calculation error
    * use oac_dev_message_registered_callbacks()
    * Add oac_battery and oac_button mfd cells to oac_dev
    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
    [firmware.ino]
2025-05-31 oac_battery.c - battery level patch
    * implements several new POWER_SUPPLY_PROPs which enable upower to detect battery capacity
    * add bat_lvl to StatusBody. bat_lvl is a firmware calculated percentage between 0 and 100 reprepresenting approximate charge level.
2025-06-01 oac_battery
    * implement shutdown upon critically low battery level.
2025-06-01 modified: software/linux/drivers/oac_battery.c
